znk-ee/ESP32-BLE-Midi-Footswitch-Line6-Floorboard/pics/closeup_1.jpg

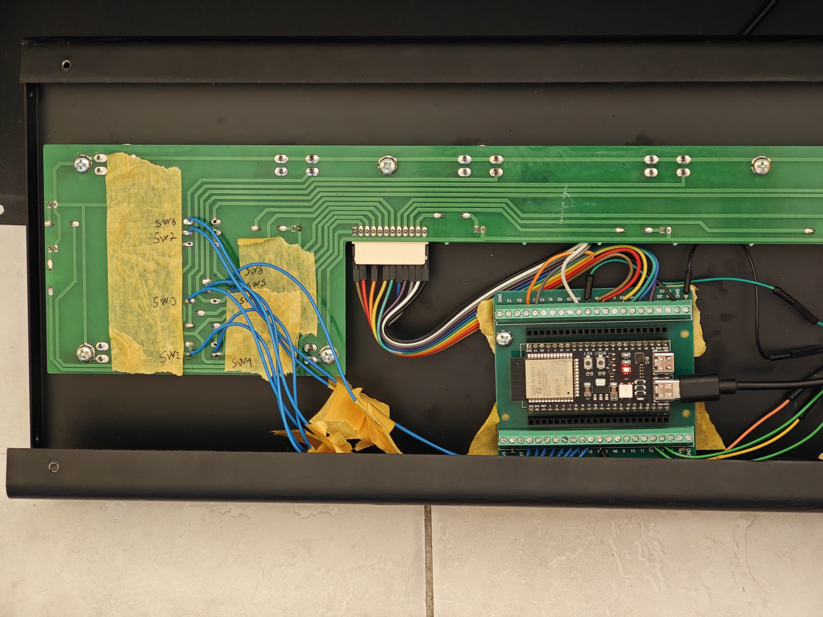
pics/closeup_1.jpg
