znk-ee/ESP32-BLE-Midi-Footswitch-Line6-Floorboard/pics/closeup_2.jpg

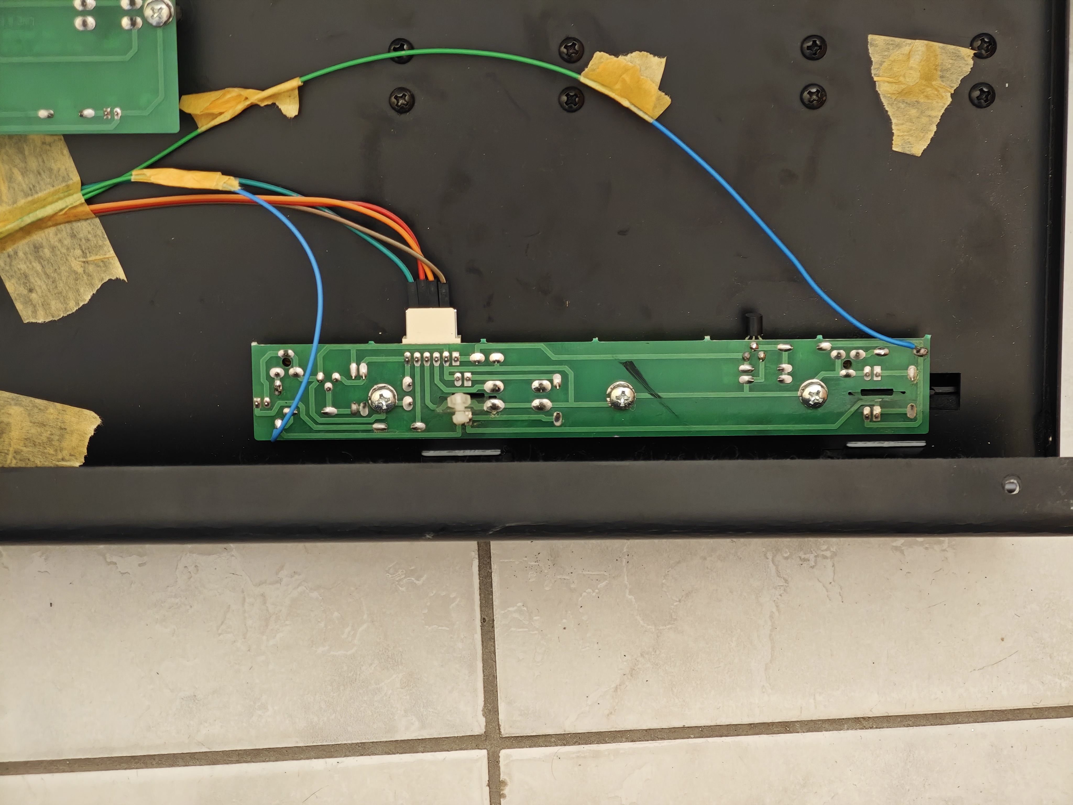
pics/closeup_2.jpg
