znk-ee/ESP32-BLE-Midi-Footswitch-Line6-Floorboard/pics/closeup_3.jpg

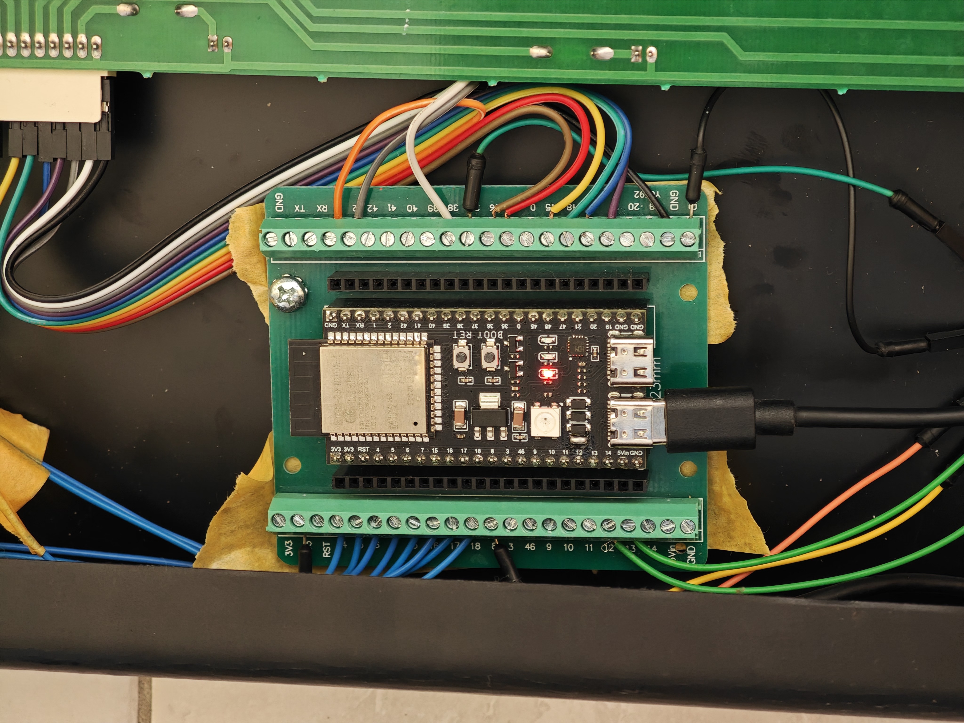
pics/closeup_3.jpg
