znk-ee/ESP32-BLE-Midi-Footswitch-Line6-Floorboard/(commit log)

2026-04-22 Revise README for clarity and additional details
    Updated README with improved clarity and additional details on features, hardware modifications, software setup, and calibration.
2026-04-22 Rename line6 board switches.jpg to line6_board_switches.jpg
2026-04-22 Rename pics/expression board front.jpg to line6_board_pedals.jpg
2026-04-22 Fix image paths and enhance calibration section
    Updated image paths in README and clarified calibration instructions.
2026-04-22 Enhance README with detailed hardware modification steps
    Clarified instructions for footswitch board modifications and added notes on wiring and LED identification.
2026-04-22 Revise README for Line6 Floorboard BLE MIDI project
    Updated project description and features for BLE MIDI controller. Enhanced calibration and setup instructions.
